artur-erik/Manikin_Hardware/Ventilations/DirectPressureSensor_2.0/DirectPressureSensor_2.0.kicad_pcb

## KiCad design Ventilations/DirectPressureSensor_2.0/DirectPressureSensor_2.0.kicad_pcb (2026-05-17)

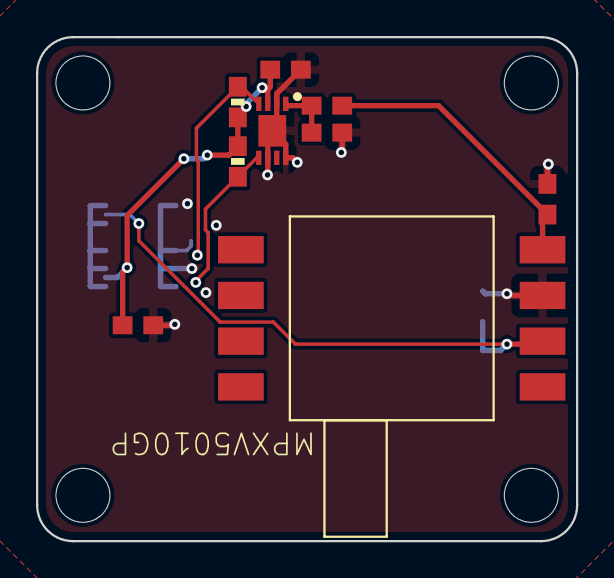
[picture p1: board DirectPressureSensor_2.0.kicad_pcb from above]

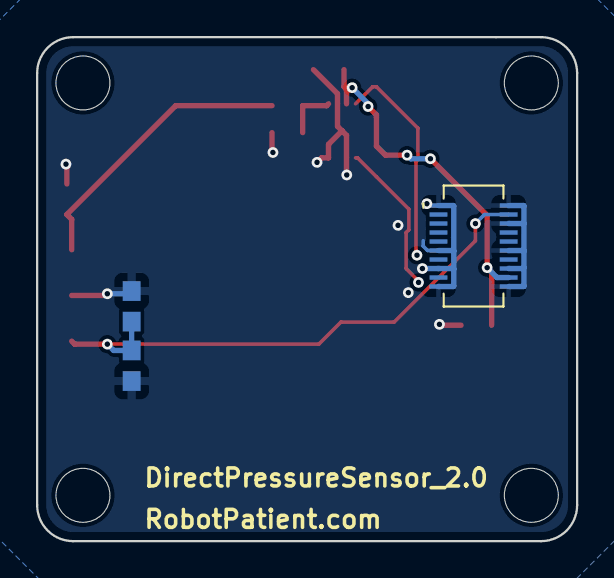
[picture p2: board DirectPressureSensor_2.0.kicad_pcb from below]

Board: 2 copper layers, 30.0 x 28.0 mm, 13 parts (3 on the bottom side), 7 nets.

Parts:
C1: 0.1uF; 0603_510
C2: 10uF; 0603_510
C3: 1.0uF; 0603_510
C4: 10nF; 0603_510
C5: 470pF; 0603_510
IC2: MCP3426A0-E_MC; SON50P300X200X100-9N
J5: 658511223020; J_Wurth_WR-BTB_658511223020
R1: 10K 0.1%; 0603_510
R2: 15K 0.1%; 0603_510
R28, R29: 4.7K; 0603-RES
U$3: MPXV5010GP; PRESSURE_SENSOR
U$40: ROBOTPATIENT_SMALL_MODULEBOARD; RP_SMALL_SENSOR_OUTLINE

Connections:
3.3V: C1.1, C2.1, IC2.3 (VDD), J5.19, R28.2, R29.2
5V: C3.2, C4.2, J5.12, U$3.2 (VS)
/Microcontroller/SCL: IC2.5 (SCL), R29.1
/Microcontroller/SDA: IC2.4 (SDA), R28.1
A0_PRESSURE_3.3V: IC2.1 (CH1+), R1.1, R2.2
A0_PRESSURE_5V: C5.2, R1.2, U$3.4 (VOUT)
GND: C1.2, C2.2, C3.1, C4.1, C5.1, IC2.2 (CH1-), IC2.6 (VSS), IC2.8 (CH2-), IC2.9 (EP), J5.1, J5.6, J5.8, J5.10, J5.11, J5.13, J5.16, J5.18, J5.20, R2.1, U$3.3 (GND)
