artur-erik/Manikin_Hardware/Compressions/CompressionSensor_2.0/CompressionSensor_2.0.kicad_pcb

## KiCad design Compressions/CompressionSensor_2.0/CompressionSensor_2.0.kicad_pcb (2026-05-17)

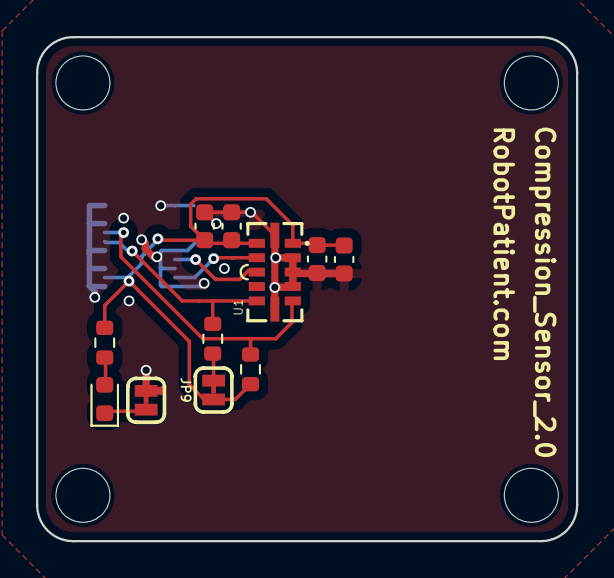
[picture p3: board CompressionSensor_2.0.kicad_pcb from above]

Board: 2 copper layers, 30.0 x 28.0 mm, 13 parts (1 on the bottom side), 5 nets.

Parts:
C1: 4.7uF; C_0603_1608Metric
C2, C3: 10uF; C_0603_1608Metric
C4: 0.1uF; C_0603_1608Metric
D2: LED; LED_0603_1608Metric
J5: 658511223020; J_Wurth_WR-BTB_658511223020
JP9: INT; SMT-JUMPER_2_NC_TRACE_SILK
PWR0: INT; SMT-JUMPER_2_NC_TRACE_SILK
R1, R2: 10k; R_0603_1608Metric
R3: 1k; R_0603_1608Metric
U1: VL53L4CD
U$40: ROBOTPATIENT_SMALL_MODULEBOARD; RP_SMALL_SENSOR_OUTLINE

Connections:
3.3V: C1.1, C2.1, C3.1, C4.1, J5.19, JP9.2, R2.2, R3.2, U1.1, U1.11
/~INT: J5.15, R1.1
/~SHUT: J5.14, R2.1
GND: C1.2, C2.2, C3.2, C4.2, J5.1, J5.6, J5.8, J5.10, J5.11, J5.13, J5.16, J5.18, J5.20, PWR0.1, U1.2, U1.3, U1.4, U1.6, U1.12
unnamed: D2.2 (A), R3.1
