artur-erik/Manikin_Hardware/SensorHub/SensorHub_2.0/SensorHub_2.0.kicad_pcb

## KiCad design SensorHub/SensorHub_2.0/SensorHub_2.0.kicad_pcb (2026-05-17)

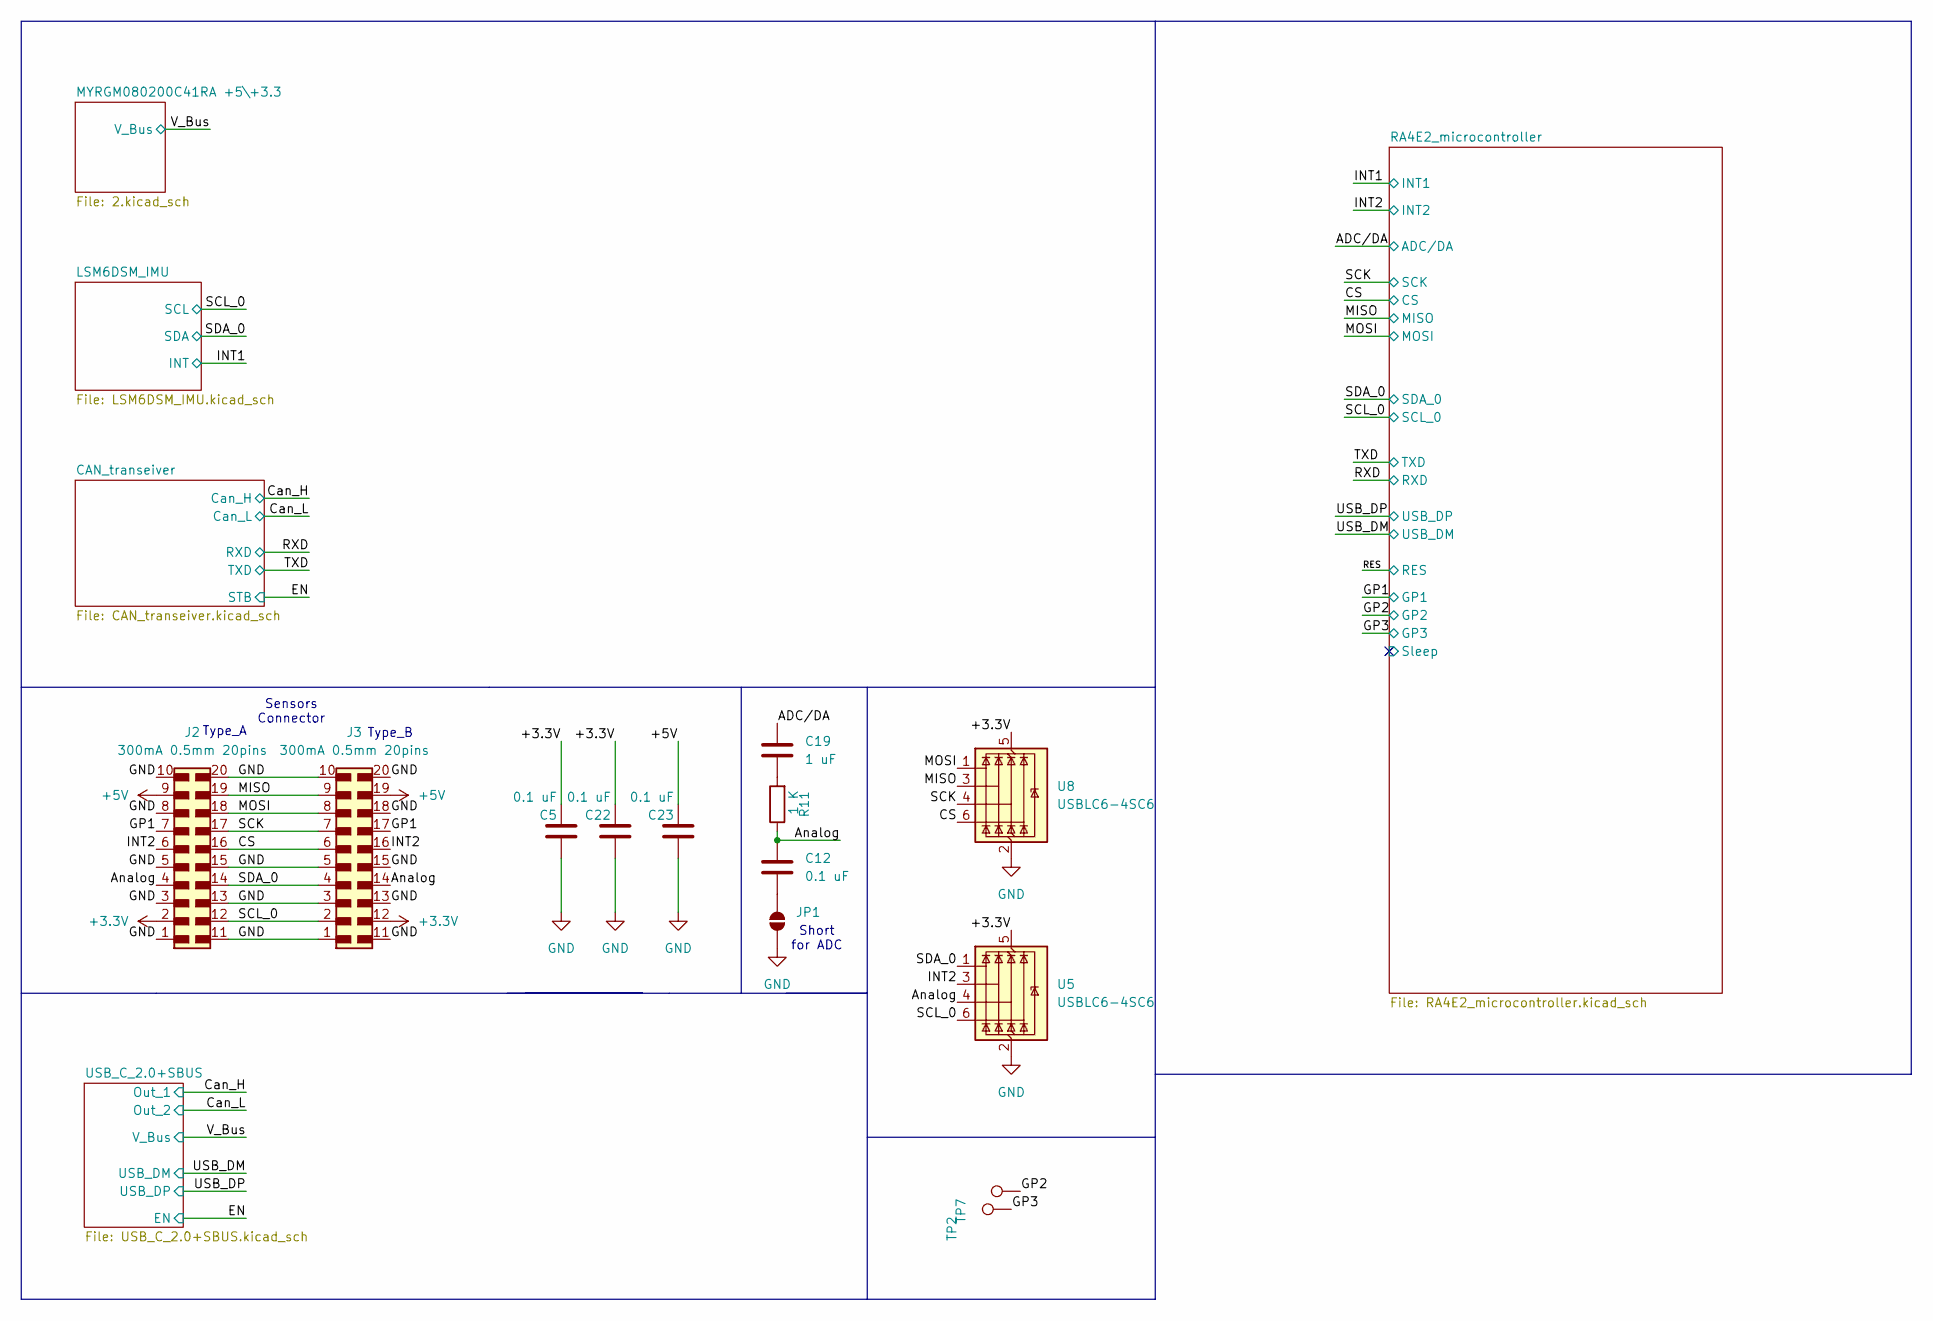
[picture p8: schematic SensorHub_2.0.kicad_sch, SensorHub_2.3_ManikinSystem26]

Parts:
C5, C12, C22, C23: 0.1 uF; C_0603_1608Metric
C19: 1 uF; C_0603_1608Metric
J2, J3: 658561423020; J_Wurth_WR-BTB_658561423020; Part Number 658561423020
JP1: SolderJumper_2_Open; SolderJumper-2_P1.3mm_Open_RoundedPad1.0x1.5mm
R11: 1 K; R_0603_1608Metric
TP2, TP7: TestPoint; TestPoint_Pad_1.0x1.0mm
U5, U8: USBLC6-4SC6; SOT-23-6; MPN USBLC6-4SC6Y

Connections:
+3.3V: C5.1, C22.1, J2.2, J3.12, U5.5 (VBUS), U8.5 (VBUS); also elsewhere on the board
+5V: C23.1, J2.9, J3.19; also elsewhere on the board
/ADC/DA: C19.1; also elsewhere on the board
/Analog: C12.1, J2.4, J3.14, R11.1, U5.4 (I/O3)
/CS: J2.16, J3.6, U8.6 (I/O4); also elsewhere on the board
/GP1: J2.7, J3.17; also elsewhere on the board
/GP2: TP7.1; also elsewhere on the board
/GP3: TP2.1; also elsewhere on the board
/INT2: J2.6, J3.16, U5.3 (I/O2); also elsewhere on the board
/MISO: J2.19, J3.9, U8.3 (I/O2); also elsewhere on the board
/MOSI: J2.18, J3.8, U8.1 (I/O1); also elsewhere on the board
/SCK: J2.17, J3.7, U8.4 (I/O3); also elsewhere on the board
/SCL_0: J2.12, J3.2, U5.6 (I/O4); also elsewhere on the board
/SDA_0: J2.14, J3.4, U5.1 (I/O1); also elsewhere on the board
GND: C5.2, C22.2, C23.2, J2.1, J2.3, J2.5, J2.8, J2.10, J2.11, J2.13, J2.15, J2.20, J3.1, J3.3, J3.5, J3.10, J3.11, J3.13, J3.15, J3.18, J3.20, JP1.1 (A), U5.2 (GND), U8.2 (GND); also elsewhere on the board
unnamed: C19.2, R11.2
unnamed: C12.2, JP1.2 (B)

Notes on the sheet:
Type_A
Sensors Connector
Type_B
Short for ADC

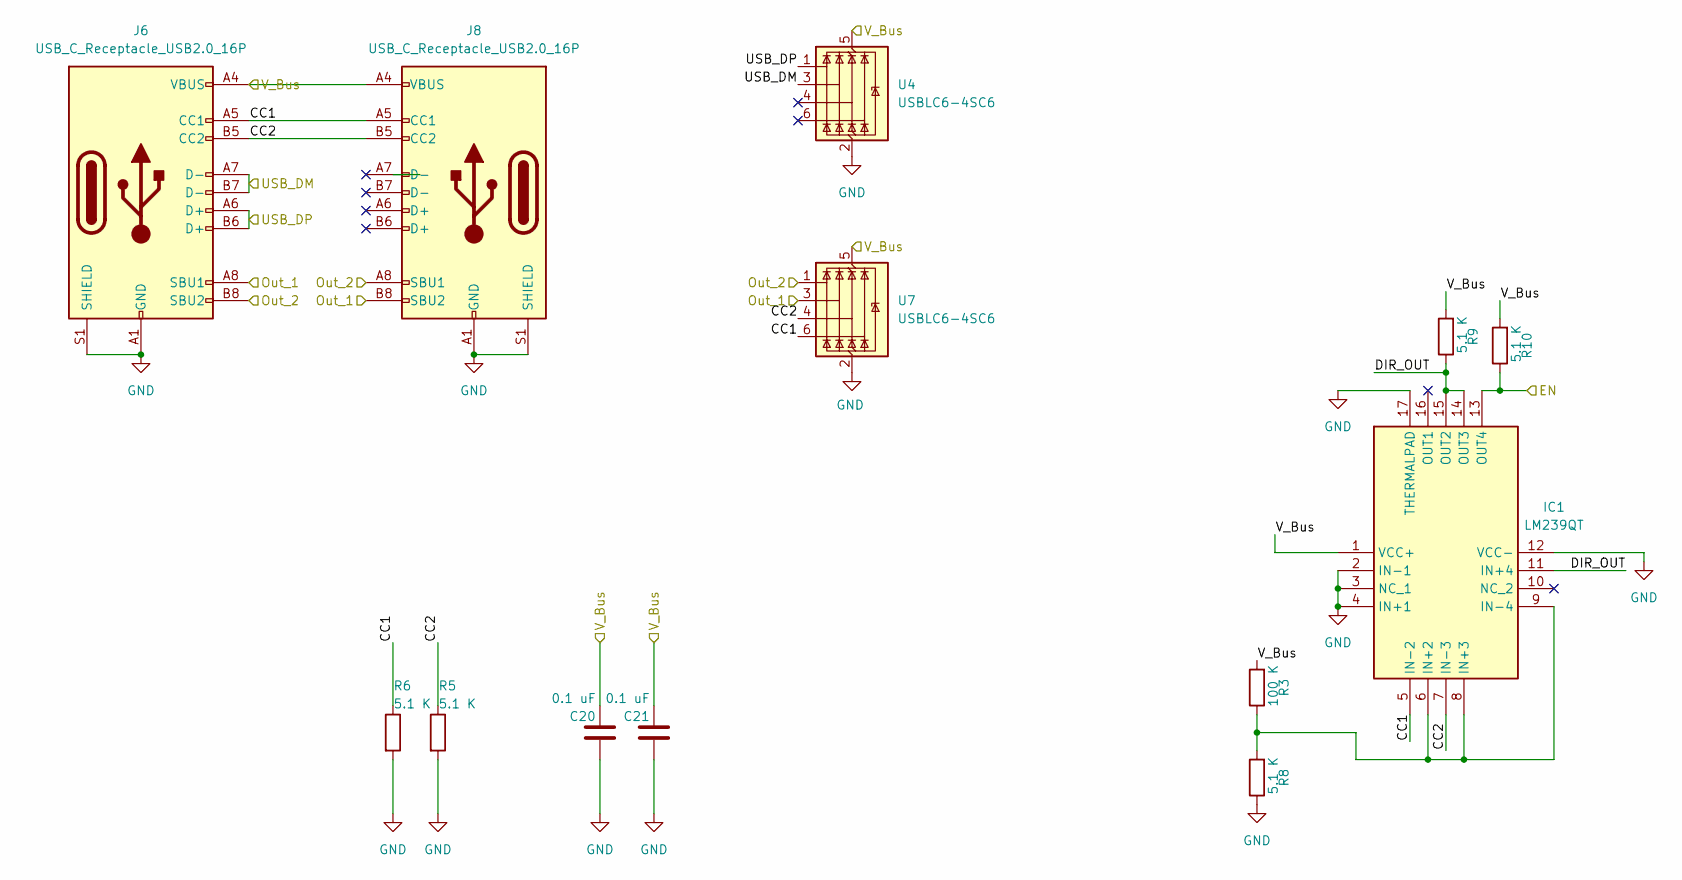
[picture p9: schematic USB_C_2.0+SBUS.kicad_sch]

Parts:
C20, C21: 0.1 uF; C_0603_1608Metric
IC1: LM239QT; QFN50P300X300X100-17N; Mouser Part Number 511-LM239QT
J6, J8: USB_C_Receptacle_USB2.0_16P; USB_C_Receptacle_Palconn_UTC16-G
R3: 100 K; R_0603_1608Metric
R5, R6, R8, R9, R10: 5.1 K; R_0603_1608Metric
U4, U7: USBLC6-4SC6; SOT-23-6; MPN USBLC6-4SC6Y

Connections:
/Can_H: J6.A8 (SBU1), J8.B8 (SBU2), U7.3 (I/O2); also elsewhere on the board
/Can_L: J6.B8 (SBU2), J8.A8 (SBU1), U7.1 (I/O1); also elsewhere on the board
/EN: IC1.13 (OUT4), R10.1; also elsewhere on the board
/USB_C_2.0+SBUS/CC1: IC1.5 (IN-2), J6.A5 (CC1), J8.A5 (CC1), R6.1, U7.6 (I/O4)
/USB_C_2.0+SBUS/CC2: IC1.7 (IN-3), J6.B5 (CC2), J8.B5 (CC2), R5.1, U7.4 (I/O3)
/USB_C_2.0+SBUS/DIR_OUT: IC1.11 (IN+4), IC1.14 (OUT3), IC1.15 (OUT2), R9.1
/USB_DM: J6.A7 (D-), J6.B7 (D-), U4.3 (I/O2); also elsewhere on the board
/USB_DP: J6.A6 (D+), J6.B6 (D+), U4.1 (I/O1); also elsewhere on the board
/V_Bus: C20.1, C21.1, IC1.1 (VCC+), J6.A4 (VBUS), J6.A9 (VBUS), J6.B4 (VBUS), J6.B9 (VBUS), J8.A4 (VBUS), J8.A9 (VBUS), J8.B4 (VBUS), J8.B9 (VBUS), R3.2, R9.2, R10.2, U4.5 (VBUS), U7.5 (VBUS); also elsewhere on the board
GND: C20.2, C21.2, IC1.2 (IN-1), IC1.3 (NC_1), IC1.4 (IN+1), IC1.12 (VCC-), IC1.17 (THERMALPAD), J6.A1 (GND), J6.A12 (GND), J6.B1 (GND), J6.B12 (GND), J6.S1 (SHIELD), J8.A1 (GND), J8.A12 (GND), J8.B1 (GND), J8.B12 (GND), J8.S1 (SHIELD), R5.2, R6.2, R8.1, U4.2 (GND), U7.2 (GND); also elsewhere on the board
unnamed: IC1.6 (IN+2), IC1.8 (IN+3), IC1.9 (IN-4), R3.1, R8.2

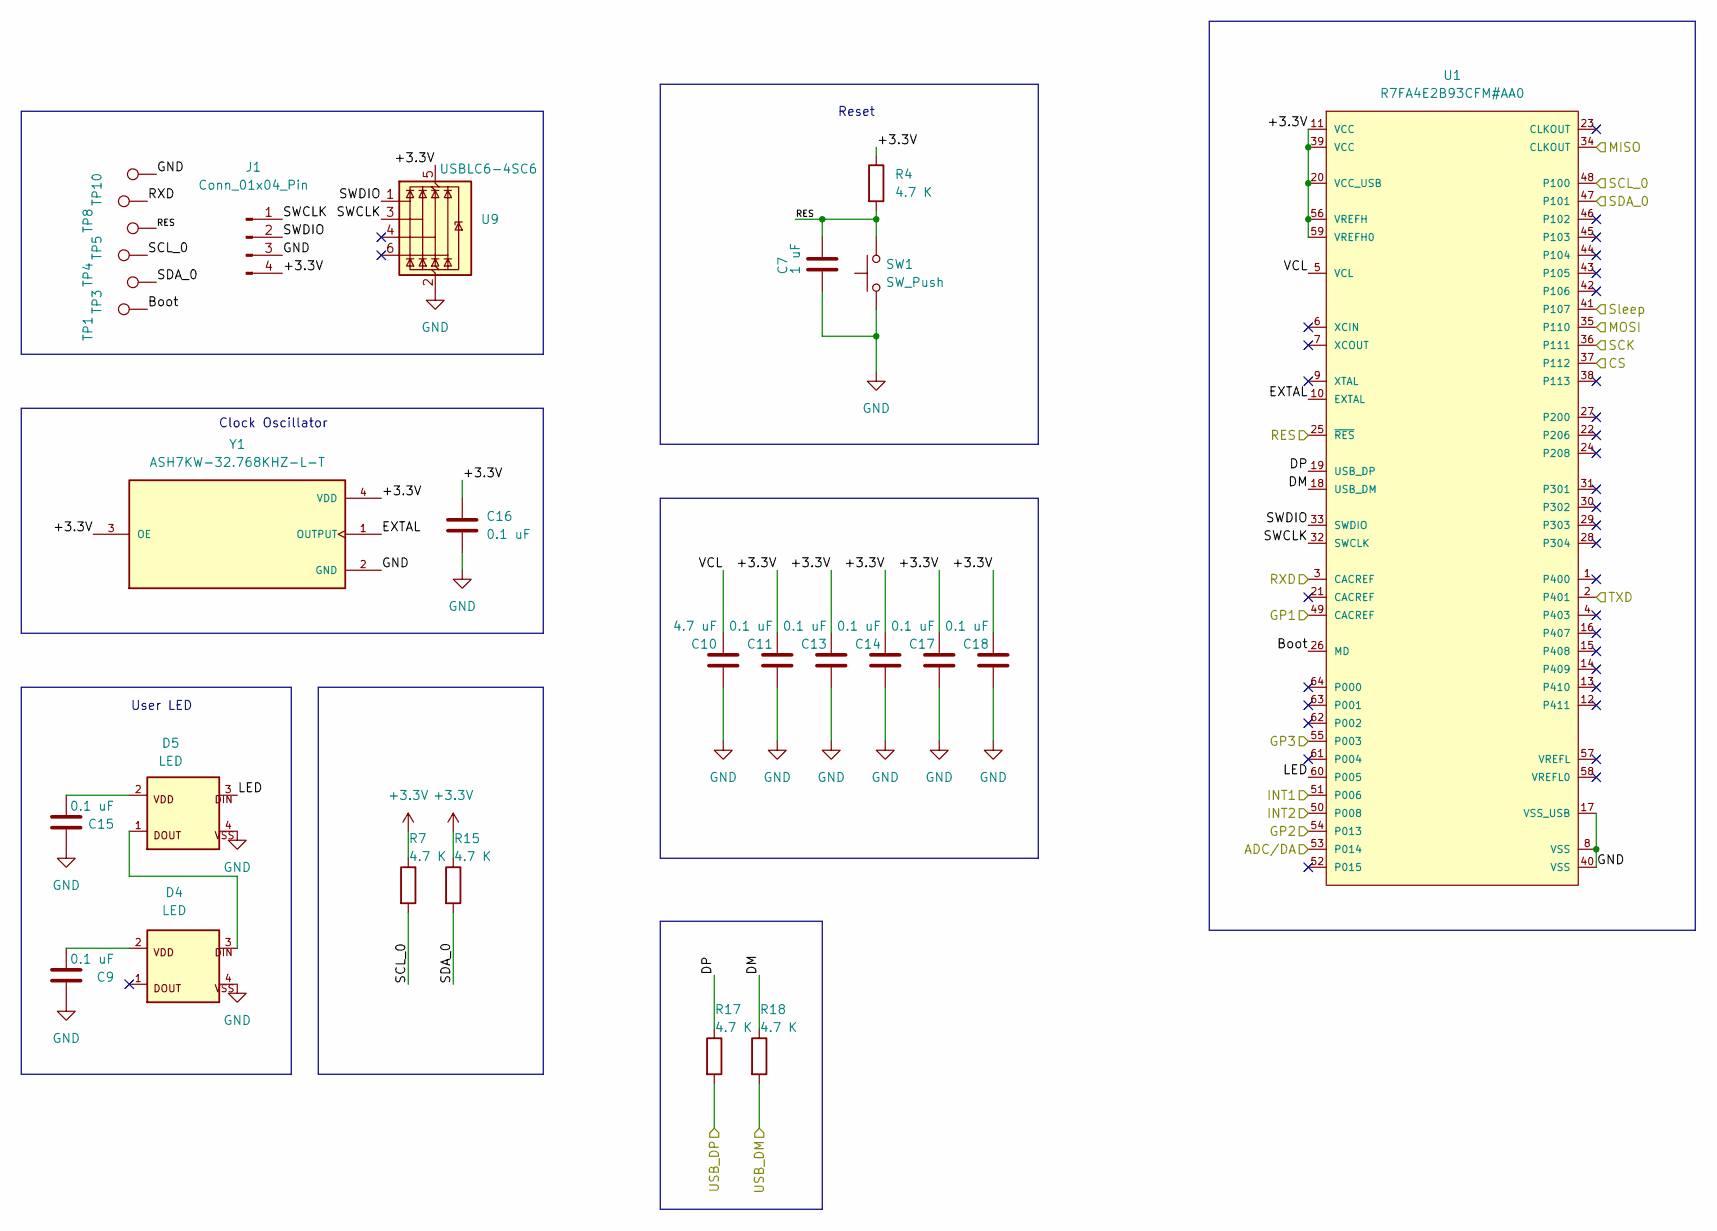
[picture p10: schematic RA4E2_microcontroller.kicad_sch]

Parts:
C7: 1 uF; C_0603_1608Metric
C9, C11, C13, C14, C15, C16, C17, C18: 0.1 uF; C_0603_1608Metric
C10: 4.7 uF; C_0603_1608Metric
D4, D5: LED; 1312020030000; MPN 1312020030000
J1: Conn_01x04_Pin; PinHeader_1x04_P1.27mm_Vertical
R4, R7, R15, R17, R18: 4.7 K; R_0603_1608Metric
SW1: SW_Push; B3U-1000P(M)-B; MPN B3U-1000PM-B
TP1, TP3, TP4, TP5, TP8, TP10: TestPoint; TestPoint_Pad_1.0x1.0mm
U1: R7FA4E2B93CFM#AA0; Renesas-PLQP0064KB-C-0-0-IPC_A; MPN R7FA4E2B93CFM#AA0
U9: USBLC6-4SC6; SOT-23-6; MPN USBLC6-4SC6Y
Y1: ASH7KW-32.768KHZ-L-T; XTAL_ASH7KW-32.768KHZ-L-T; PARTREV 07.07.2021

Connections:
+3.3V: C11.1, C13.1, C14.1, C16.1, C17.1, C18.1, J1.4, R4.1, R7.1, R15.1, U1.11 (VCC), U1.20 (VCC_USB), U1.39 (VCC), U1.56 (VREFH), U1.59 (VREFH0), U9.5 (VBUS), Y1.3 (OE), Y1.4 (VDD); also elsewhere on the board
/ADC/DA: U1.53 (P014); also elsewhere on the board
/CS: U1.37 (P112); also elsewhere on the board
/GP1: U1.49 (CACREF); also elsewhere on the board
/GP2: U1.54 (P013); also elsewhere on the board
/GP3: U1.55 (P003); also elsewhere on the board
/INT1: U1.51 (P006); also elsewhere on the board
/INT2: U1.50 (P008); also elsewhere on the board
/MISO: U1.34 (CLKOUT); also elsewhere on the board
/MOSI: U1.35 (P110); also elsewhere on the board
/RA4E2_microcontroller/Boot: TP1.1, U1.26 (MD)
/RA4E2_microcontroller/DM: R18.1, U1.18 (USB_DM)
/RA4E2_microcontroller/DP: R17.1, U1.19 (USB_DP)
/RA4E2_microcontroller/EXTAL: U1.10 (EXTAL), Y1.1 (OUTPUT)
/RA4E2_microcontroller/LED: D5.3, U1.60 (P005)
/RA4E2_microcontroller/SWCLK: J1.1, U1.32 (SWCLK), U9.3 (I/O2)
/RA4E2_microcontroller/SWDIO: J1.2, U1.33 (SWDIO), U9.1 (I/O1)
/RA4E2_microcontroller/Sleep: U1.41 (P107)
/RA4E2_microcontroller/VCL: C10.1, U1.5 (VCL)
/RES: C7.1, R4.2, SW1.2, TP5.1, U1.25 (~RES)
/RXD: TP8.1, U1.3 (CACREF); also elsewhere on the board
/SCK: U1.36 (P111); also elsewhere on the board
/SCL_0: R7.2, TP4.1, U1.48 (P100); also elsewhere on the board
/SDA_0: R15.2, TP3.1, U1.47 (P101); also elsewhere on the board
/TXD: U1.2 (P401); also elsewhere on the board
/USB_DM: R18.2; also elsewhere on the board
/USB_DP: R17.2; also elsewhere on the board
GND: C7.2, C9.2, C10.2, C11.2, C13.2, C14.2, C15.2, C16.2, C17.2, C18.2, D4.4, D5.4, J1.3, SW1.1, TP10.1, U1.8 (VSS), U1.17 (VSS_USB), U1.40 (VSS), U9.2 (GND), Y1.2 (GND); also elsewhere on the board
unnamed: C9.1, D4.2
unnamed: C15.1, D5.2
unnamed: D4.3, D5.1

Notes on the sheet:
User LED
Clock Oscillator
Reset

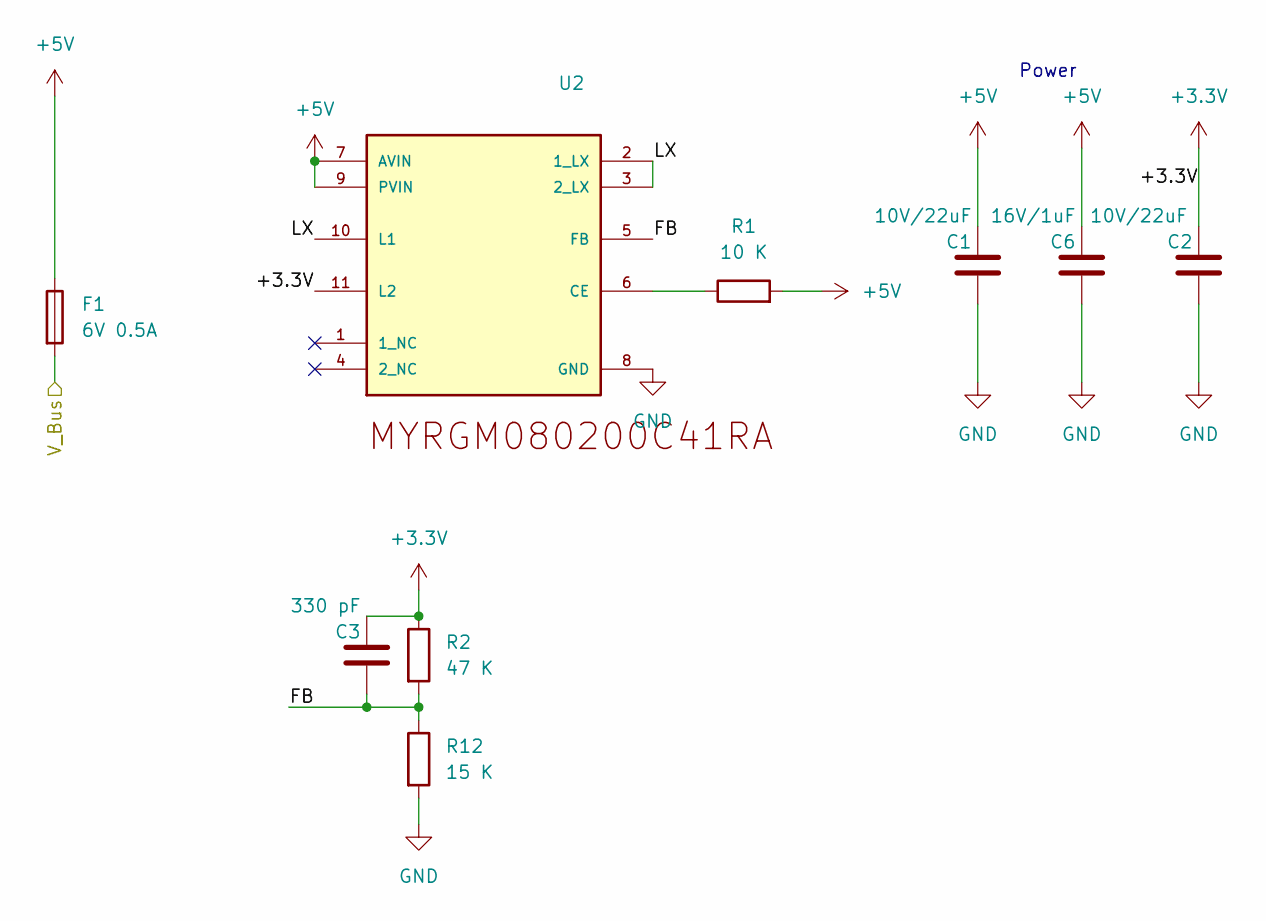
[picture p11: schematic 2.kicad_sch]

Parts:
C1, C2: 10V/22uF; C_0603_1608Metric
C3: 330 pF; C_0603_1608Metric
C6: 16V/1uF; C_0603_1608Metric
F1: 6V 0.5A; Fuse_1206_3216Metric_Pad1.42x1.75mm_HandSolder; MPN SMD1206B050TF
R1: 10 K; R_0603_1608Metric
R2: 47 K; R_0603_1608Metric
R12: 15 K; R_0603_1608Metric
U2: MYRGM080200C41RA; MURATA_MYRGM080200C41RA_0; MOUSER_PART_NUMBER 81-MYRGM080200C41RA

Connections:
+3.3V: C2.1, C3.1, R2.1, U2.11 (L2); also elsewhere on the board
+5V: C1.1, C6.1, F1.1, R1.2, U2.7 (AVIN), U2.9 (PVIN); also elsewhere on the board
/MYRGM080200C41RA +5\+3.3/FB: C3.2, R2.2, R12.1, U2.5 (FB)
/MYRGM080200C41RA +5\+3.3/LX: U2.2 (1_LX), U2.3 (2_LX), U2.10 (L1)
/V_Bus: F1.2; also elsewhere on the board
GND: C1.2, C2.2, C6.2, R12.2, U2.8 (GND); also elsewhere on the board
unnamed: R1.1, U2.6 (CE)

Notes on the sheet:
Power

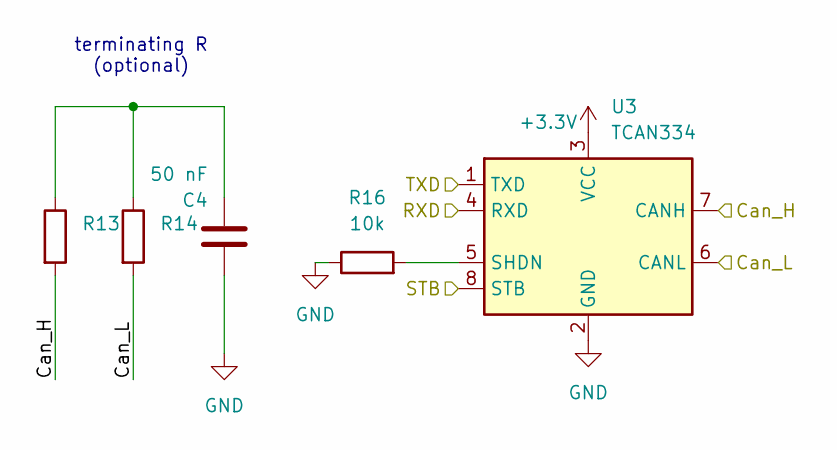
[picture p12: schematic CAN_transeiver.kicad_sch]

Parts:
C4: 50 nF; C_0603_1608Metric
R13, R14: R_0603_1608Metric
R16: 10k; R_0603_1608Metric
U3: TCAN334; TSOT-23-8; MPN TCAN334GDCNT

Connections:
+3.3V: U3.3 (VCC); also elsewhere on the board
/Can_H: R13.2, U3.7 (CANH); also elsewhere on the board
/Can_L: R14.2, U3.6 (CANL); also elsewhere on the board
/EN: U3.8 (STB); also elsewhere on the board
/RXD: U3.4 (RXD); also elsewhere on the board
/TXD: U3.1 (TXD); also elsewhere on the board
GND: C4.2, R16.1, U3.2 (GND); also elsewhere on the board
unnamed: C4.1, R13.1, R14.1
unnamed: R16.2, U3.5 (SHDN)

Notes on the sheet:
terminating R (optional)

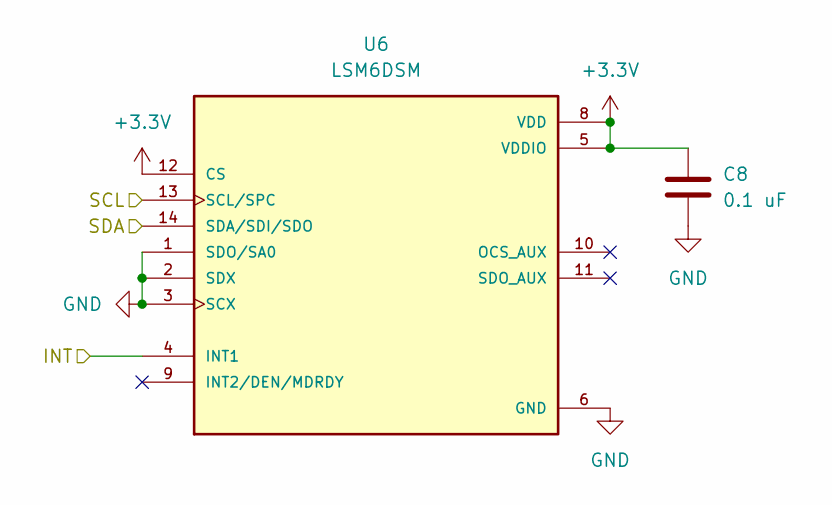
[picture p13: schematic LSM6DSM_IMU.kicad_sch]

Parts:
C8: 0.1 uF; C_0603_1608Metric
U6: LSM6DSM; PQFN50P300X250X86-14N; PARTREV Rev 7

Connections:
+3.3V: C8.1, U6.5 (VDDIO), U6.8 (VDD), U6.12 (CS); also elsewhere on the board
/INT1: U6.4 (INT1); also elsewhere on the board
/SCL_0: U6.13 (SCL/SPC); also elsewhere on the board
/SDA_0: U6.14 (SDA/SDI/SDO); also elsewhere on the board
GND: C8.2, U6.1 (SDO/SA0), U6.2 (SDX), U6.3 (SCX), U6.6 (GND), U6.7 (GND); also elsewhere on the board

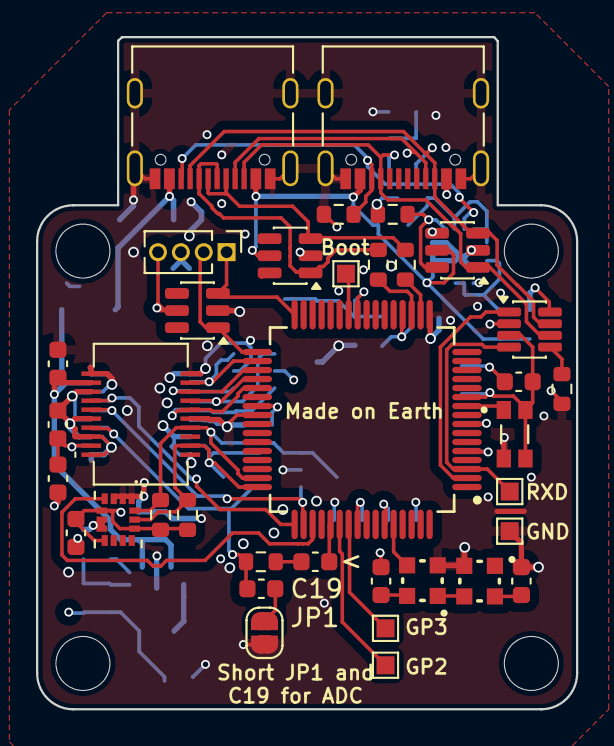
[picture p14: board SensorHub_2.0.kicad_pcb from above]

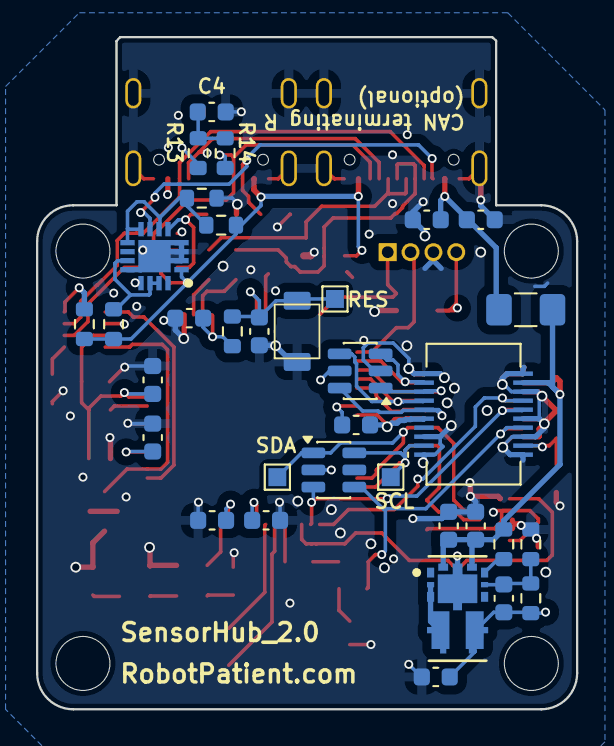
[picture p15: board SensorHub_2.0.kicad_pcb from below]

Board: 4 copper layers, 30.0 x 37.3 mm, 71 parts (34 on the bottom side), 47 nets.

Other parts of the board:
U$40: ROBOTPATIENT_SMALL_MODULEBOARD; RP_SMALL_SENSOR_OUTLINE
