artur-erik/Manikin_Hardware/Compressions/FingerPositionSensor_1/Eagle version/ThoraxSensor3.0.6_2024_VCNT2020.brd

## EAGLE design Compressions/FingerPositionSensor_1/Eagle version/ThoraxSensor3.0.6_2024_VCNT2020.brd (2026-03-20)

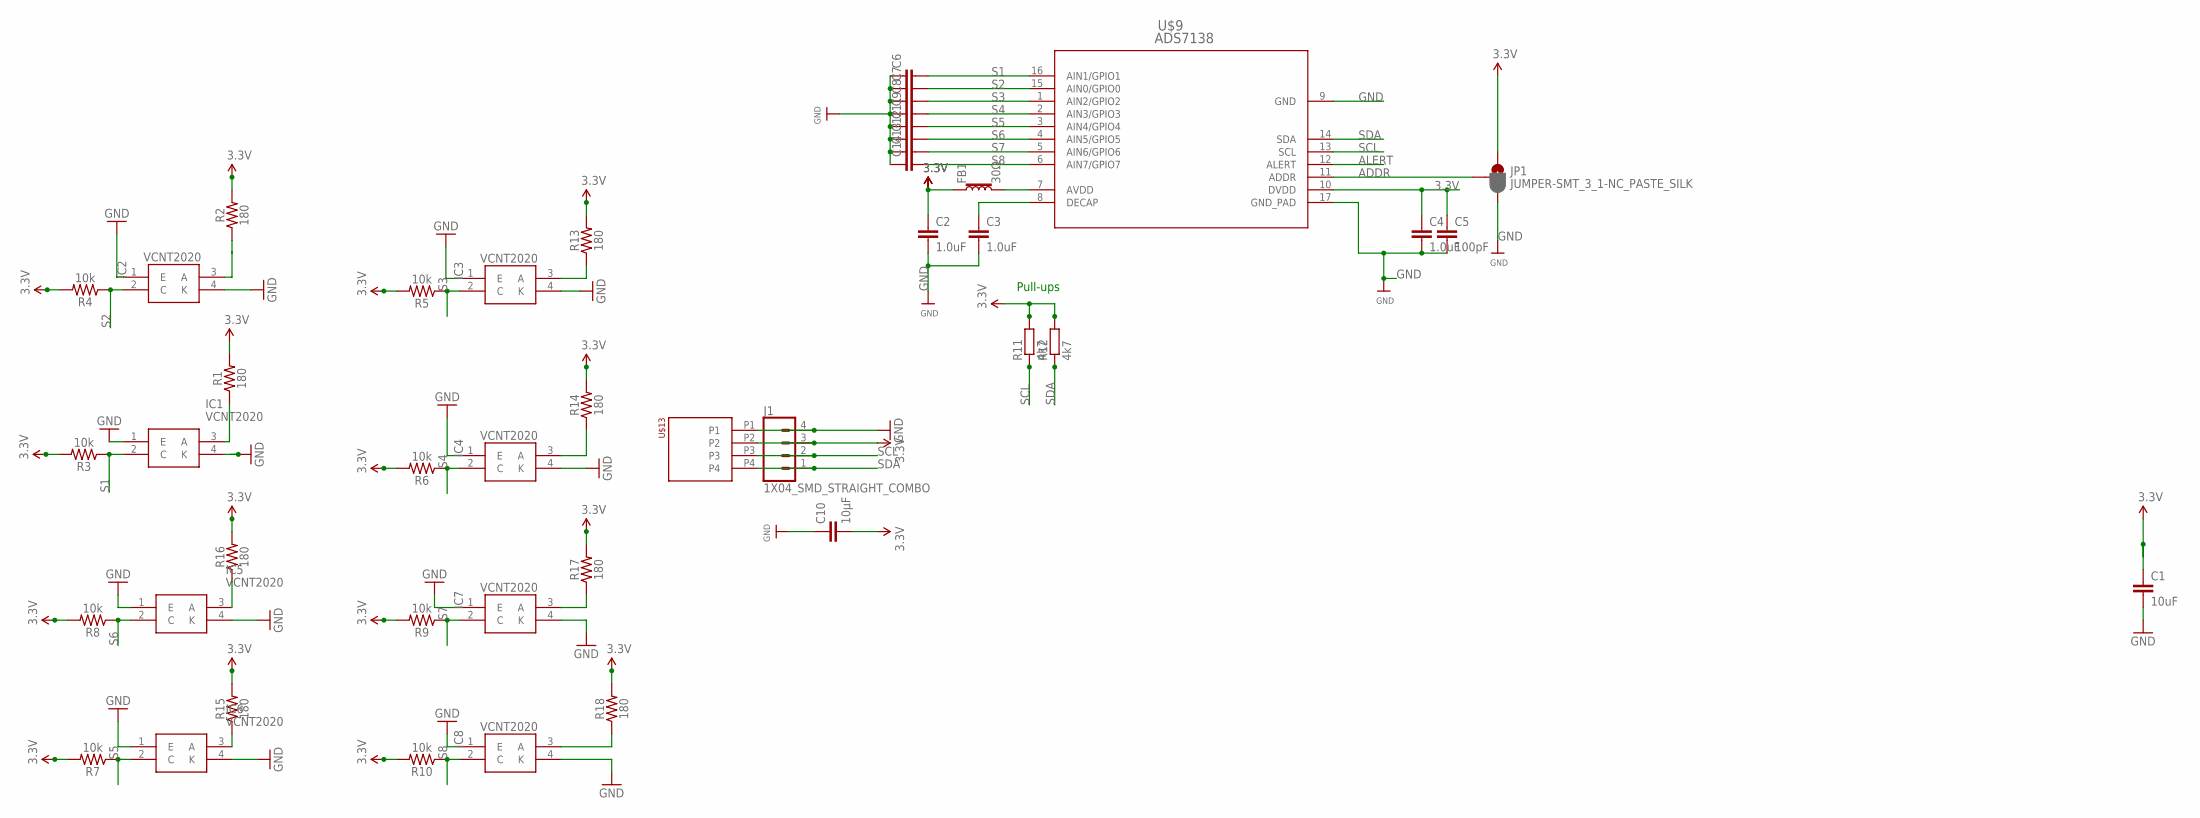
[picture p16: schematic ThoraxSensor3.0.6_2024_VCNT2020.sch]

Parts:
C1: 10uF; 0805
C2, C3, C4: 1.0uF; 0603
C5: 100pF; 0603
C6, C7, C8, C9, C11, C12, C13, C14: 0.1uF; 0603
C10: 10µF; C0805
FB1: 30Ω; 0603
IC1, IC2, IC3, IC4, IC5, IC6, IC7, IC8: VCNT2020
J1: 1X04_SMD_STRAIGHT_COMBO; 1X04_SMD_VERTICAL_COMBO
JP1: JUMPER-SMT_3_1-NC_PASTE_SILK; SMT-JUMPER_3_1-NC_PASTE_SILK
R1, R2, R13, R14, R15, R16, R17, R18: 180; 0603
R3, R4, R5, R6, R7, R8, R9, R10: 10k; 0603
R11, R12: 4k7; R0603
U$9: ADS7138; QFN_8IRTER_TEX
U$13: PHOENIX_PTSM_M4_TH_ANGLEMIRRORED_SILK_I2C; PTSM_M4_TH_ANGLE_NEUTRAL_MIRRORED

Connections:
3.3V: C1.1, C2.1, C4.1, C5.1, C10.2, FB1.1, J1.3, JP1.1, R1.2, R2.2, R3.2, R4.2, R5.2, R6.2, R7.2, R8.2, R9.2, R10.2, R11.2, R12.2, R13.2, R14.2, R15.2, R16.2, R17.2, R18.2, U$9.10 (DVDD), U$13.P2
ADDR: JP1.2, U$9.11 (ADDR)
ALERT: U$9.12 (ALERT)
DECAP: C3.1, U$9.8 (DECAP)
GND: C1.2, C2.2, C3.2, C4.2, C5.2, C6.1, C7.1, C8.1, C9.1, C10.1, C11.1, C12.1, C13.1, C14.1, IC1.1 (E), IC1.4 (K), IC2.1 (E), IC2.4 (K), IC3.1 (E), IC3.4 (K), IC4.1 (E), IC4.4 (K), IC5.1 (E), IC5.4 (K), IC6.1 (E), IC6.4 (K), IC7.1 (E), IC7.4 (K), IC8.1 (E), IC8.4 (K), J1.4, JP1.3, U$9.9 (GND), U$9.17 (GND_PAD), U$13.P1
unnamed: IC1.3 (A), R1.1
unnamed: IC2.3 (A), R2.1
unnamed: IC3.3 (A), R13.1
unnamed: IC4.3 (A), R14.1
unnamed: IC6.3 (A), R15.1
unnamed: IC5.3 (A), R16.1
unnamed: IC7.3 (A), R17.1
unnamed: IC8.3 (A), R18.1
unnamed: FB1.2, U$9.7 (AVDD)
S1: C6.2, IC1.2 (C), R3.1, U$9.16 (AIN1/GPIO1)
S2: C7.2, IC2.2 (C), R4.1, U$9.15 (AIN0/GPIO0)
S3: C8.2, IC3.2 (C), R5.1, U$9.1 (AIN2/GPIO2)
S4: C9.2, IC4.2 (C), R6.1, U$9.2 (AIN3/GPIO3)
S5: C11.2, IC6.2 (C), R7.1, U$9.3 (AIN4/GPIO4)
S6: C12.2, IC5.2 (C), R8.1, U$9.4 (AIN5/GPIO5)
S7: C13.2, IC7.2 (C), R9.1, U$9.5 (AIN6/GPIO6)
S8: C14.2, IC8.2 (C), R10.1, U$9.6 (AIN7/GPIO7)
SCL: J1.2, R11.1, U$9.13 (SCL), U$13.P3
SDA: J1.1, R12.1, U$9.14 (SDA), U$13.P4

Notes on the sheet:
Pull-ups

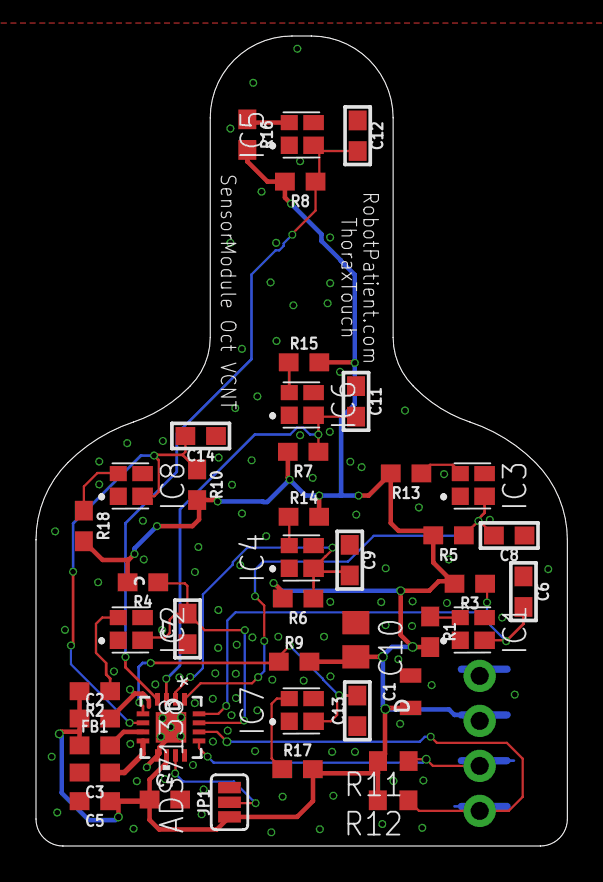
[picture p17: board ThoraxSensor3.0.6_2024_VCNT2020.brd from above]

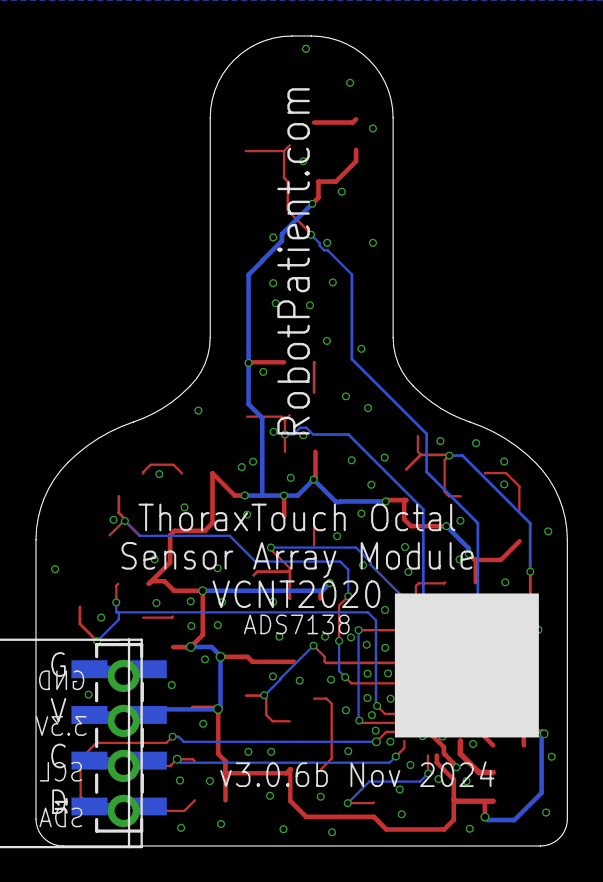
[picture p18: board ThoraxSensor3.0.6_2024_VCNT2020.brd from below]

Board: 2 copper layers, 29.5 x 45.0 mm, 45 parts (2 on the bottom side), 23 nets.
