artur-erik/Manikin_Hardware/(commit log)

2026-03-20 Initial update
    [Compressions_TOF_VL53L4CD_v1.0.0_mar2025.kicad_pcb, Compressions_TOF_VL53L4CD_v1.0.0_mar2025.kicad_sch, Diff_PressureSensor_SDP_v1.1_sep2023.kicad_pcb, Diff_PressureSensor_SDP_v1.1_sep2023.kicad_sch, Pressure_Module_MPXV5010GP_v1.0_jan2026.kicad_pcb, Pressure_Module_v1.0_feb2024.kicad_pcb, Pressure_Module_v1.0_feb2024.kicad_sch, Pressure_Module_v1.0_feb2024_1.kicad_sch]
2026-03-20 Voltage regulation
    [SensorHub_2.0.kicad_sch]
2026-03-30 1st version SensorHub
    [BMI270.step, SensorHub_2.0.kicad_pcb, SensorHub_2.0.kicad_sch]
2026-04-05 New connector BM46B-12DP-0.35V(53)
    [BM46B-12DP-0.35V_53_.step, SensorHub_2.0.kicad_pcb, SensorHub_2.0.kicad_sch]
2026-04-06 New testPoints and Res filter
    [SensorHub_2.0.kicad_pcb, SensorHub_2.0.kicad_sch]
2026-04-06 Mirrored connector
    [SensorHub_2.0.kicad_pcb, SensorHub_2.0.kicad_sch]
2026-04-06 Audio jumper
    [SensorHub_2.0.kicad_pcb, SensorHub_2.0.kicad_sch]
2026-04-09 New hierarchy
    [2.kicad_sch, BM46B-12DP-0.35V_53_.step, CAN_transeiver.kicad_sch, LSM6DSM.step, LSM6DSM_IMU.kicad_sch, RA4E2_microcontroller.kicad_sch, SensorHub_2.0.kicad_pcb, SensorHub_2.0.kicad_sch]
2026-04-12 32k oscillator
    [CAN_transeiver.kicad_sch, LSM6DSM_IMU.kicad_sch, RA4E2_microcontroller.kicad_sch, SensorHub_2.0.kicad_pcb, SensorHub_2.0.kicad_sch, USB_C.kicad_sch]
2026-04-15 PCB 1st upd
    [RA4E2_microcontroller.kicad_sch, SensorHub_2.0.kicad_pcb, SensorHub_2.0.kicad_sch, USB_C_2.0+SBUS.kicad_sch]
2026-04-16 PCB upd 2
    [2.kicad_sch, RA4E2_microcontroller.kicad_sch, SensorHub_2.0.kicad_pcb, SensorHub_2.0.kicad_sch, USB_C_2.0+SBUS.kicad_sch]
2026-04-17 Fix 17.04
    [SensorHub_2.0.kicad_pcb, SensorHub_2.0.kicad_sch]
2026-04-17 Fix2 17.04
    [RA4E2_microcontroller.kicad_sch, SensorHub_2.0.kicad_pcb, SensorHub_2.0.kicad_sch]
2026-04-17 JLCPCB limits
    [2.kicad_sch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]
2026-04-27 PCB fix
    [SensorHub_2.0.kicad_pcb, SensorHub_2.0.kicad_sch, USB_C.kicad_sch, USB_C_3.0.kicad_sch]
2026-04-27 Text fix
    [SensorHub_2.0.kicad_pcb]
2026-04-29 Vesrion 2
    [2.kicad_sch, CAN_transeiver.kicad_sch, RA4E2_microcontroller.kicad_sch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]
2026-04-30 MPN + CC fix
    [2.kicad_sch, CAN_transeiver.kicad_sch, LSM6DSM_IMU.kicad_sch, RA4E2_microcontroller.kicad_sch, SensorHub_2.0.kicad_pcb, SensorHub_2.0.kicad_sch, USB_C_2.0+SBUS.kicad_sch]
2026-04-30 MPN + CC fix2
    [SensorHub_2.0.kicad_pcb]
2026-05-17 v 2.3
    [2.kicad_sch, CAN_transeiver.kicad_sch, LSM6DSM_IMU.kicad_sch, RA4E2_microcontroller.kicad_sch, SensorHub_2.0.kicad_pcb, SensorHub_2.0.kicad_sch, USB_C_2.0+SBUS.kicad_sch]
2026-05-17 lib fix
    [SensorHub_2.0.kicad_pcb]
2026-05-17 Compression 1
    [CompressionSensor_2.0.kicad_pcb, CompressionSensor_2.0.kicad_sch, Compressions_TOF_VL53L4CD_v1.0.0_mar2025.kicad_pcb, Compressions_TOF_VL53L4CD_v1.0.0_mar2025.kicad_sch, ThoraxSensor3.0.6_2024_VCNT2020.brd, ThoraxSensor3.0.6_2024_VCNT2020.kicad_pcb, ThoraxSensor3.0.6_2024_VCNT2020.kicad_sch, ThoraxSensor3.0.6_2024_VCNT2020.sch]
